GrayHatGuy/picopasco/readme

## picoponicscan
 *  Central sensor monitor and control firmware for an economical and scalable hydroponic system.
 *  
 *  Reads air temp, humidity, VOC, CO2, Soil H2O, TDS, EC, and water temp.
 *  Sensor metrics will eventually be used as a feed forward mechanism for closed loop 
 *  control of lighting, mixing, irrigation, and air quality/HVAC.  
 *  
 *  additional libraries required for a successfull build:
 *  https://github.com/Seeed-Studio/SGP30_Gas_Sensor
 *  https://www.arduinolibraries.info/libraries/sensirion-i2-c-sht4x
 *      
 *  mailto://GrayHatGuy@GrayHatGuy.com
