GrayHatGuy/picopasco/picts/future_state_upgrades_relay8X_sensors7X_Heat_Humidity_relayunused2X.jpeg

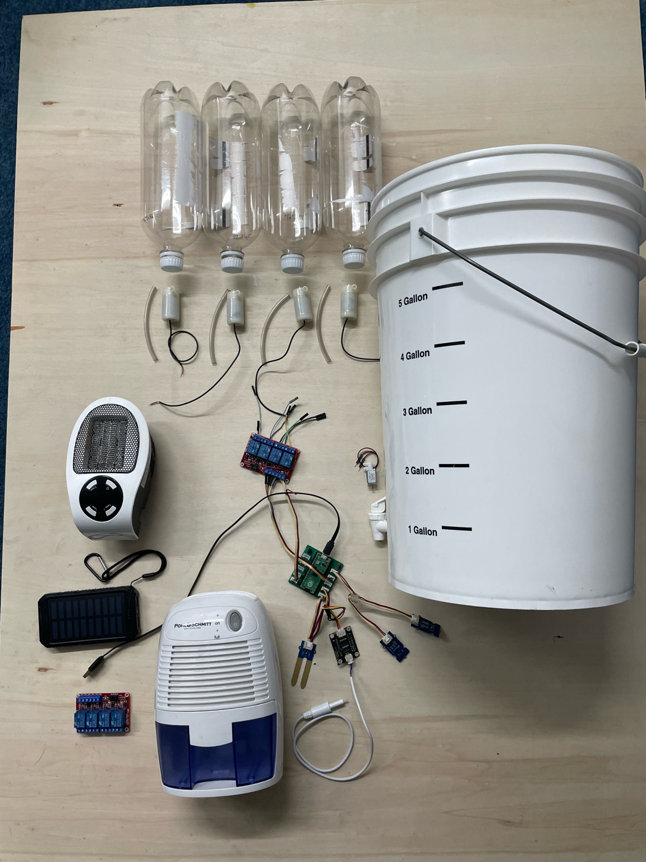
picts/future_state_upgrades_relay8X_sensors7X_Heat_Humidity_relayunused2X.jpeg
