GrayHatGuy/picopasco/picts/IMG_6527.JPG

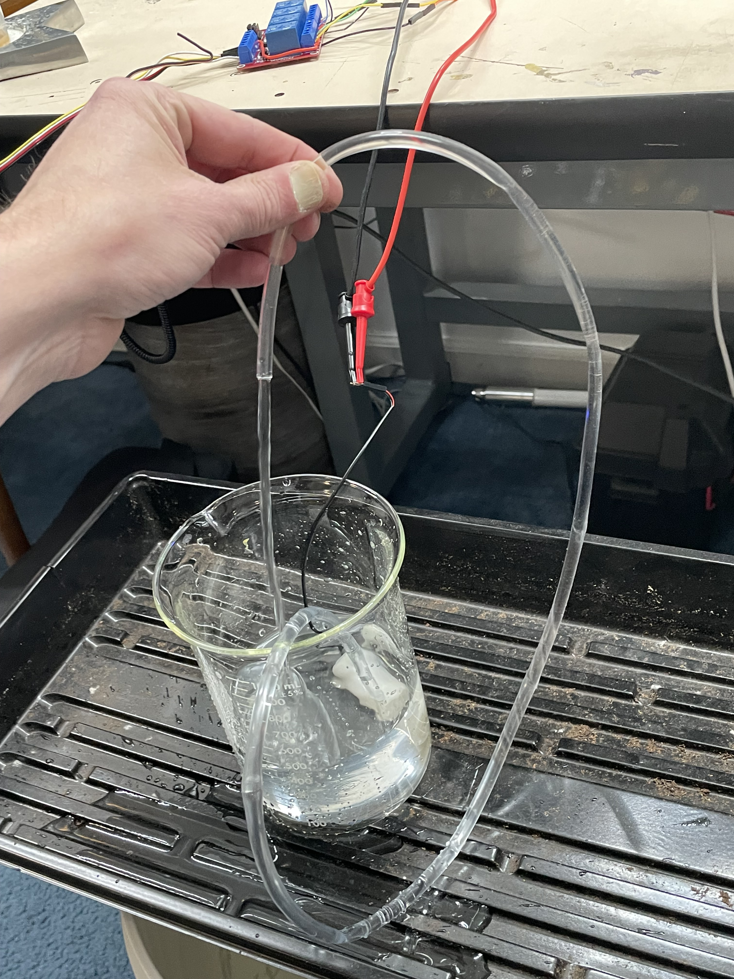
picts/IMG_6527.JPG
