GrayHatGuy/picopasco/picts/IMG_6532.JPG

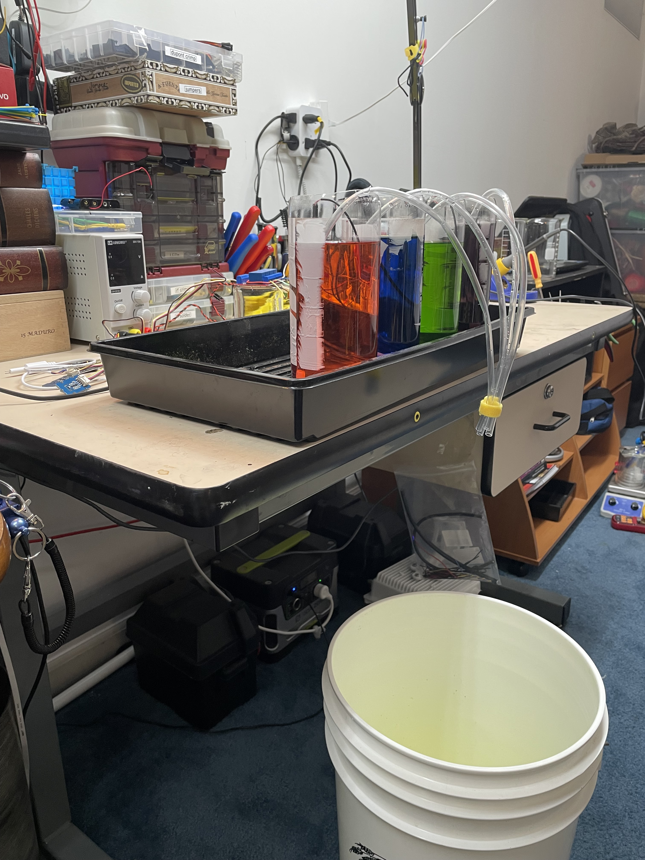
picts/IMG_6532.JPG
