GrayHatGuy/picopasco/picts/IMG_6537.JPG

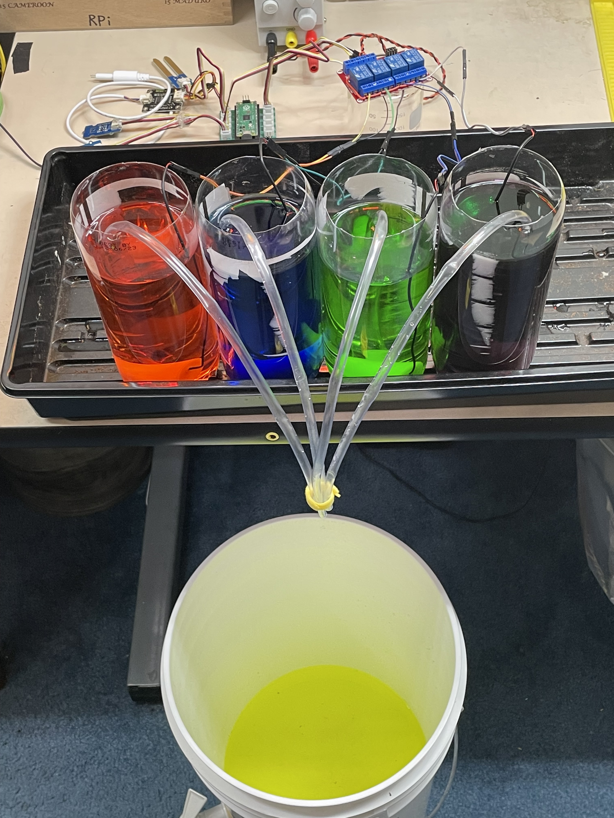
picts/IMG_6537.JPG
