GrayHatGuy/picopasco/picts/present_state_relayX4_sensorsX7.jpeg

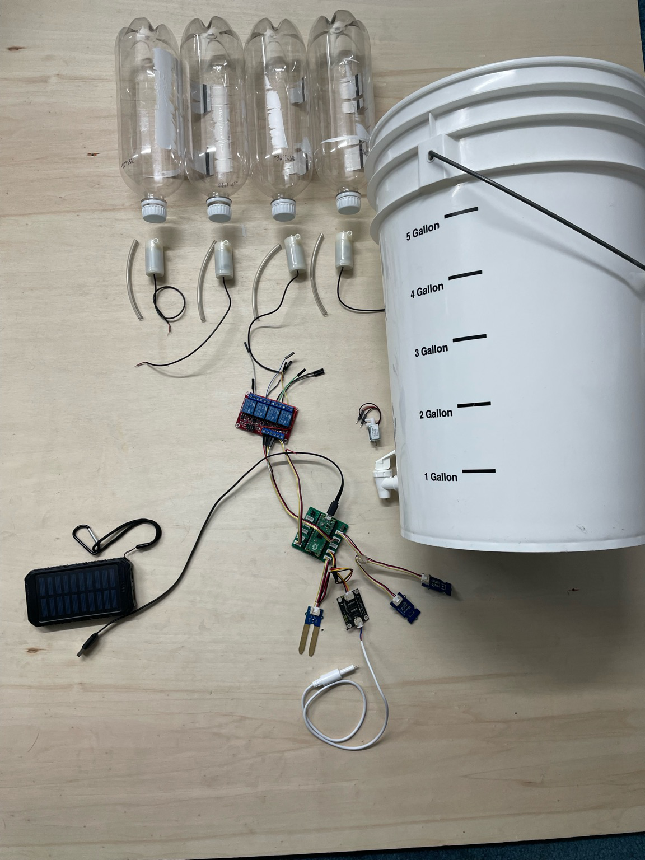
picts/present_state_relayX4_sensorsX7.jpeg
