GrayHatGuy/picopasco/(threads)

Thread 3 (2023-02-25):

2.0 i2c/flash issues

GrayHatGuy, 2023-02-25:
i2c connectivity board detect and flashing issues after upgrade to pio and arduino 2.0.3 from mbed board variant to https://github.com/earlephilhower/arduino-pico. Resolution in process requires code revision 2v1.

GrayHatGuy, 2023-02-27:
see euler release vV2.7182818284590452353602874713527

Closed 2023-02-27.

Thread 6 (2023-03-31):

Missing part from the BOM: I2C Hub from SEEED

cyberchucktx, 2023-03-31:
All:

There is a part missing from the BOM (Bill of Materials) that IS shown on the picture of the components: a 4-port
I2C hub from SEEED Studio.

Here's the part on the SEEED Studio online catalog: https://www.seeedstudio.com/Grove-I2C-Hub.html

It is $3.20, and available from the US Warehouse so shipping lead times are reasonable (2-5 days using their standard shipping method). Free shipping in the US if three parts are ordered.

Charlie

GrayHatGuy, 2023-03-31:
Here is the part.  103100142 | Digi-Key Electronicsdigikey.comOn Mar 31, 2023, at 12:16, Charlie Lindahl ***@***.***> wrote:
All:
There is a part missing from the BOM (Bill of Materials) that IS shown on the picture of the components: a 4-port
I2C hub from SEEED Studio.
Here's the part on the SEEED Studio online catalog: https://www.seeedstudio.com/Grove-I2C-Hub.html
It is $3.20, and available from the US Warehouse so shipping lead times are reasonable (2-5 days using their standard shipping method). Free shipping in the US if three parts are ordered.
Charlie

—Reply to this email directly, view it on GitHub, or unsubscribe.You are receiving this because you are subscribed to this thread.Message ID: ***@***.***>

GrayHatGuy, 2023-03-31:
You don’t really need it if hardwired but it makes it easier with the seeed grove connectors On Mar 31, 2023, at 12:16, Charlie Lindahl ***@***.***> wrote:
All:
There is a part missing from the BOM (Bill of Materials) that IS shown on the picture of the components: a 4-port
I2C hub from SEEED Studio.
Here's the part on the SEEED Studio online catalog: https://www.seeedstudio.com/Grove-I2C-Hub.html
It is $3.20, and available from the US Warehouse so shipping lead times are reasonable (2-5 days using their standard shipping method). Free shipping in the US if three parts are ordered.
Charlie

—Reply to this email directly, view it on GitHub, or unsubscribe.You are receiving this because you are subscribed to this thread.Message ID: ***@***.***>

cyberchucktx, 2023-03-31:
I was just adding this to the BOM for completeness so the BOM matches the graphic of all the setup.

Keith was trying to assemble the entire project and didn't have this piece. I've ordered it for him and hopefully he'll have it next week. In the meanwhile he can use just the temp/humidity sensor for now and add the other sensor later.

Once Keith has it together & running I'll get the pieces too and have the project running in Houston.
