GrayHatGuy/picopasco/(commit log)

2023-02-18 Add files via upload
    specifies custom GPIO maps for using I2C on the Grove pico breakout. A1-A0 unchanged. UART not used.
2023-02-21 Add files via upload
    initial release of main.cpp
    includes pin defines
    includes ino copy
2023-02-21 Add files via upload
    servo trigger example
2023-02-21 Add files via upload
    simple sensor scan sketch
2023-02-25 Add files via upload
    Initial release of mix and sensor scan combined
2023-02-25 Update readme.md
    ✅ ~integrate code into main.cpp~
2023-02-25 Update picopascoV2.0_main.cpp
    line 48 Serial.print(printscan) added to scan() exit. Alternative method using printscan as string return from scan().
2023-02-27 Add files via upload
    Resolved 2.0 i2c/flash issues #3 complete rewrite. Added functions for scan sensor() and mixing stiritup() and led toggle blink().
    Verified interval triggers mix state with mix=1 flag.
    17 loop test no issues.
    Added check timer to verify user input mix recipe setpoint SP vs process value(PV).
2023-02-27 Add files via upload
    future state dry fit additional relay 2X bank, humidifier, and heater.
2023-02-27 Add files via upload
    V2.7182818284590452353602874713527
    serial terminal output of 7x sensor scan and triggering of user specified mix relay pumps.
2023-02-27 Add files via upload
    pumps did not turn off after mix, Added digital write and check to verify pumps off. Changed blink() whil mixing to provide visual queue of state.
2023-03-03 Add files via upload
    stefan release V3.741832 document demo minor changes to print formatting and pump duty cycle and mixing times.
2023-03-03 Update readme.md
    pH sensor added to part list
2023-03-03 Add files via upload
    Added pH sensor.
2023-03-03 Delete repo_full picopasco wire.png
    add A0 pH
2023-03-04 Create picopasco-main-V4.3597447222071-alpha-hartree-pid
